mahata/bookshelf/stl/half_shell.stl

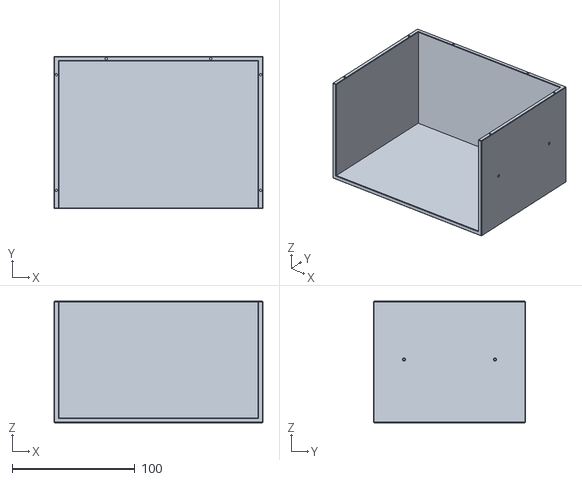
[picture p5: CAD file, 2026-10-13]
stl/half_shell.stl
170.0 x 124.0 x 99.0
