mahata/bookshelf/stl/test_coupon.stl

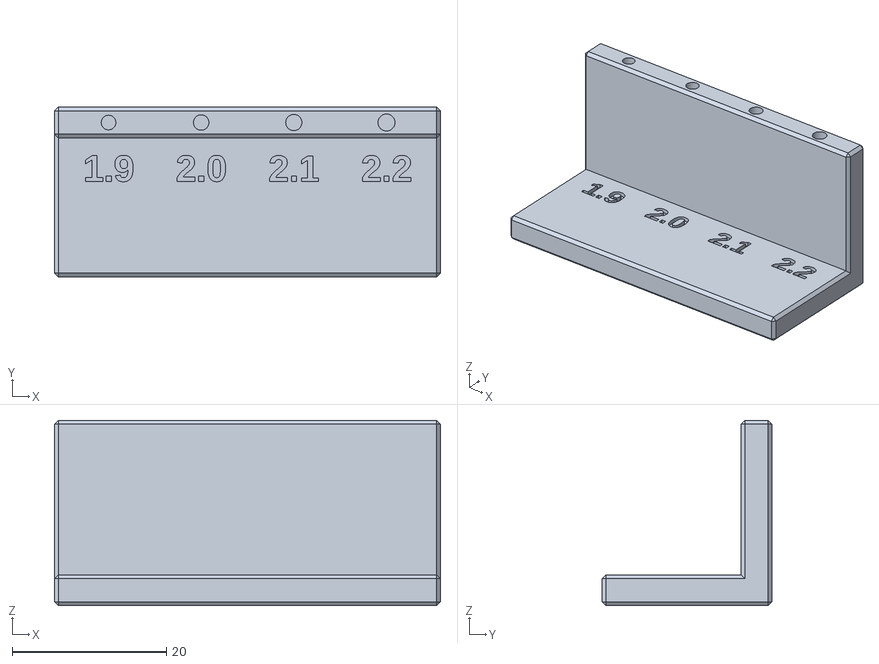
[picture p6: CAD file, 2026-10-13]
stl/test_coupon.stl
50.0 x 22.0 x 24.0
