mahata/bookshelf/(commit log)

2026-10-09 Add modular manga bookshelf for Bambu Lab A1 mini
    Each 162x120x190 mm compartment (about 10 shinsho-size manga) is built
    from two identical 170x124x99 mm half shells; the upper one is the same
    part rotated 180 degrees about the front-back axis. Filament dowels and
    glue join halves and neighboring compartments; asserts check bed fit,
    hole wall thickness, and that dowel holes stay mirror-symmetric so the
    flipped half lines up.
    Includes a dowel-fit test coupon, default STLs, preview images, a
    Makefile (local OpenSCAD or USE_DOCKER=1), and a Japanese README.
    Copilot-Session: 355fb983-cc36-407d-a4b2-b4205b0fffe4
    [bookshelf.scad, half_shell.stl, test_coupon.stl]
2026-10-09 Use standard Japanese 3D-printing terms in docs
    Replace 試し刷り片 with テストピース and 象の足 with エレファントフット,
    matching the terms used in Bambu Studio's Japanese UI.
    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
    [bookshelf.scad]
